ab0tj/RubeCron/README.md

This is just a goofy SBC I created for myself that is also a binary clock.
I have made it public in case it is helpful to anyone else, but it isn't intended to be finished product by any means.

That said, it works for me but YMMV.
