ab0tj/RubeCron/KiCad/v1-v2/RubeCron-r2.pdf

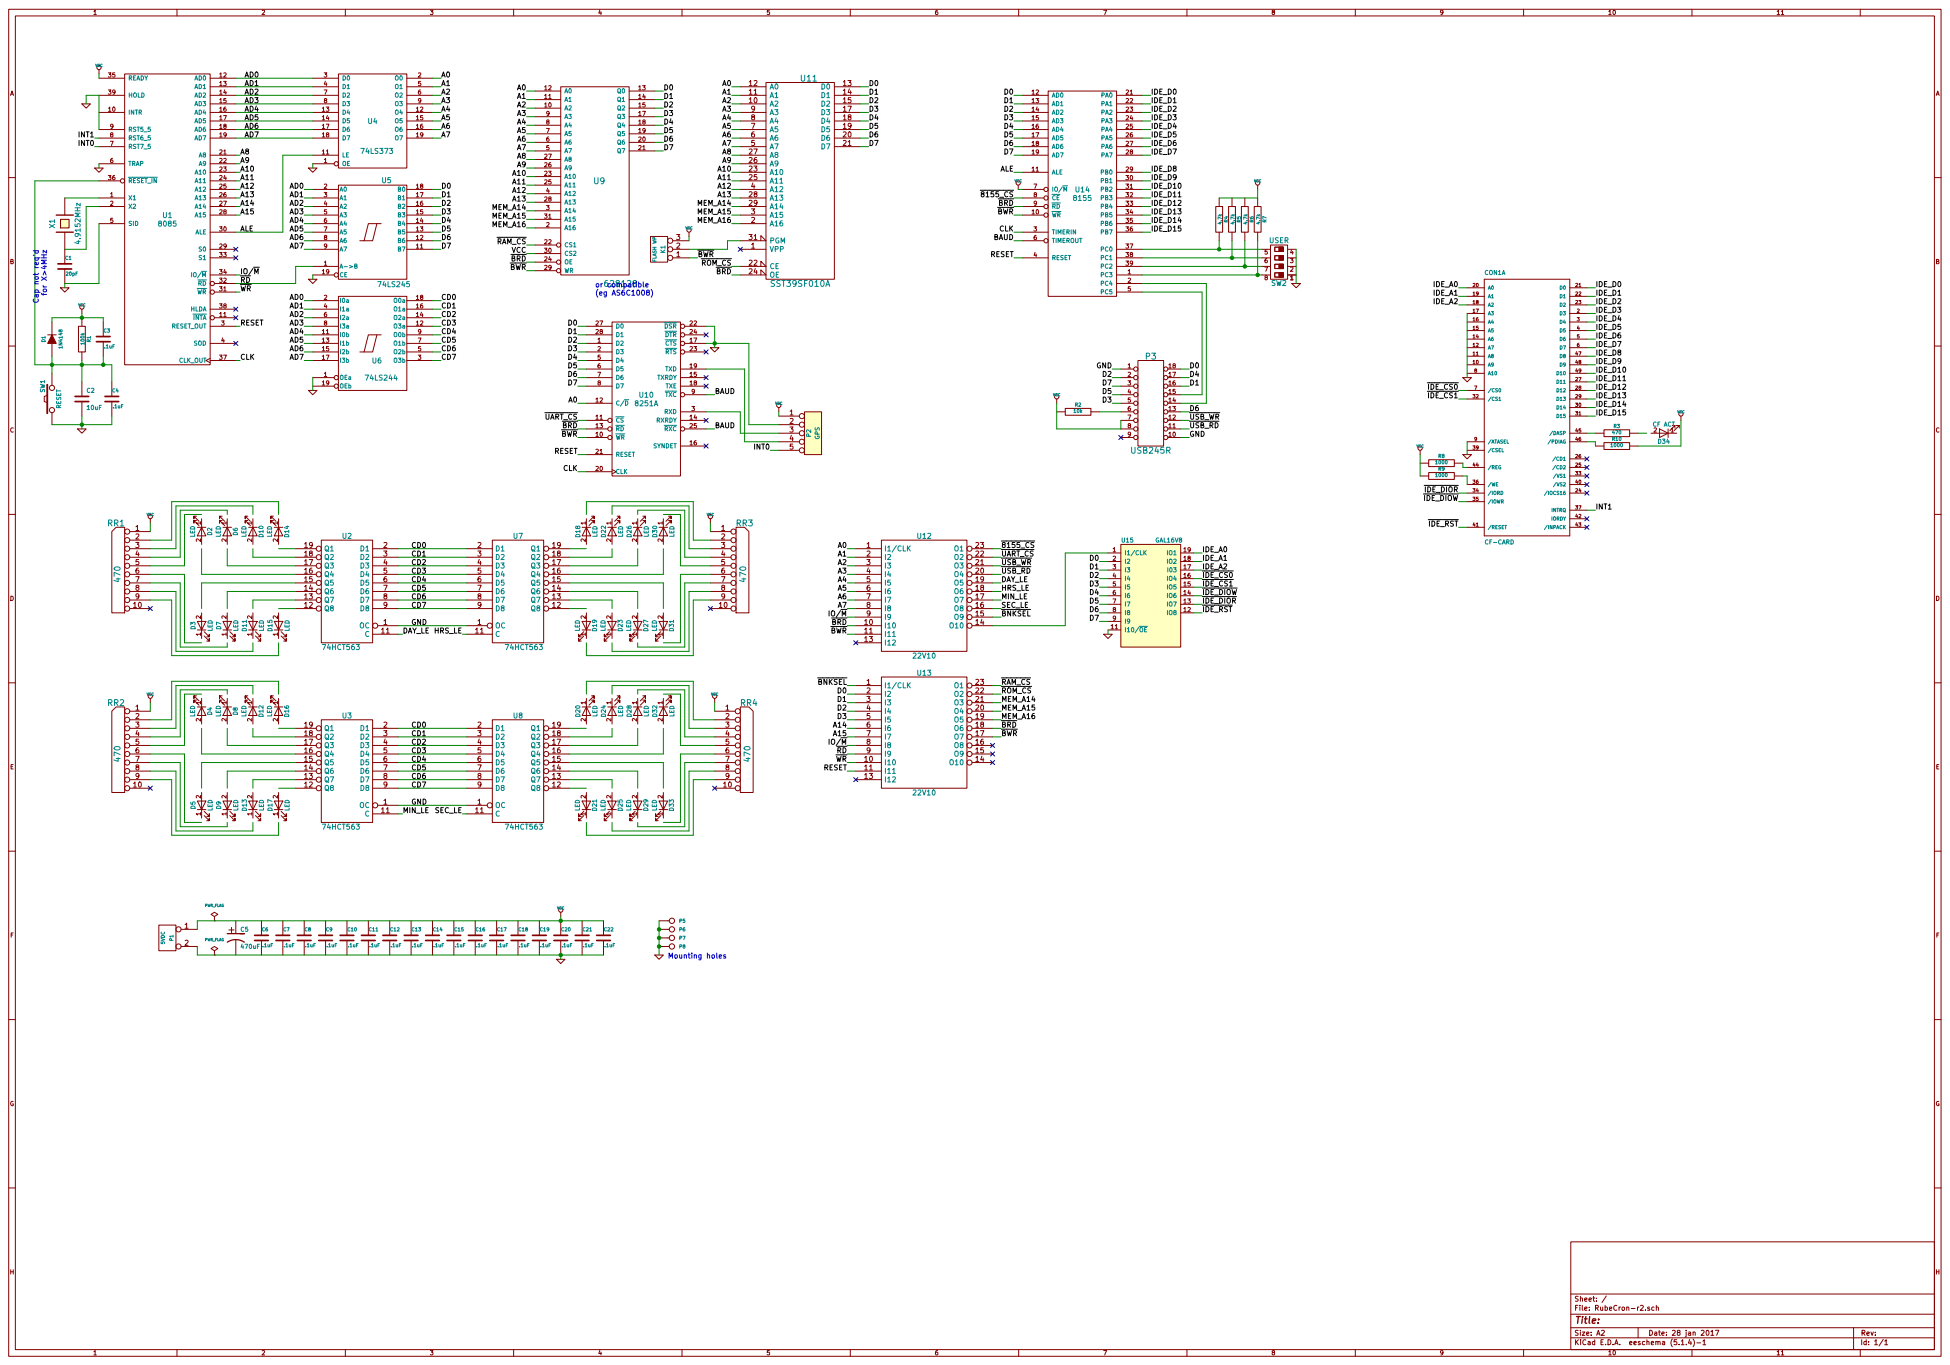
[picture p1: page 1]

Id: 1/1 Title: File: RubeCron-r2.sch Sheet: /
