ab0tj/RubeCron/KiCad/v3-v4/RubeCron-r3.pdf

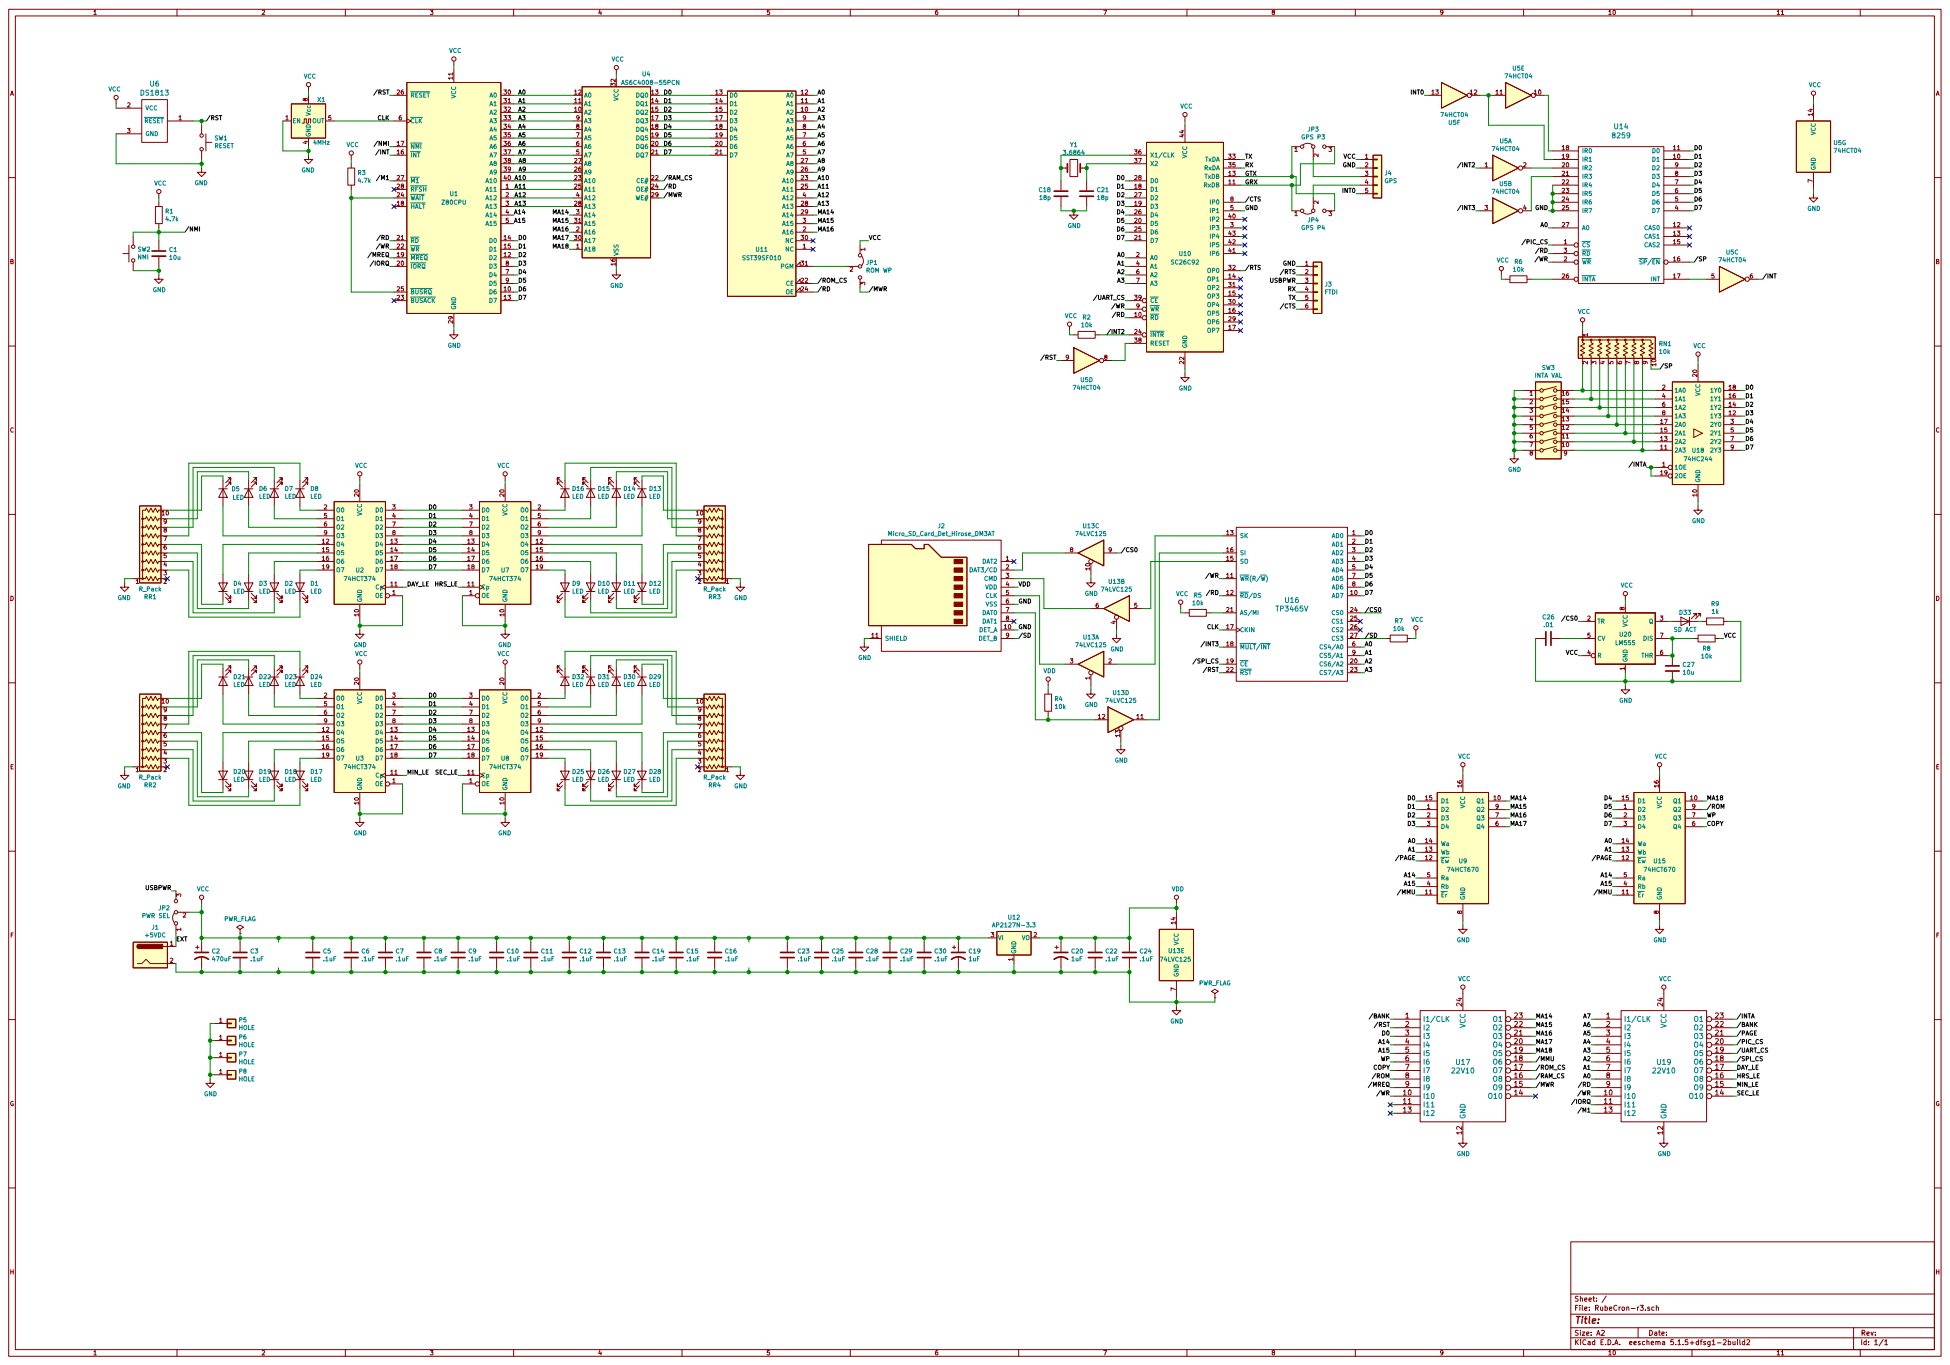
[picture p2: page 1]

Id: 1/1 Title: File: RubeCron-r3.sch Sheet: /
