ab0tj/RubeCron/KiCad/v1-v2/RubeCron.pdf

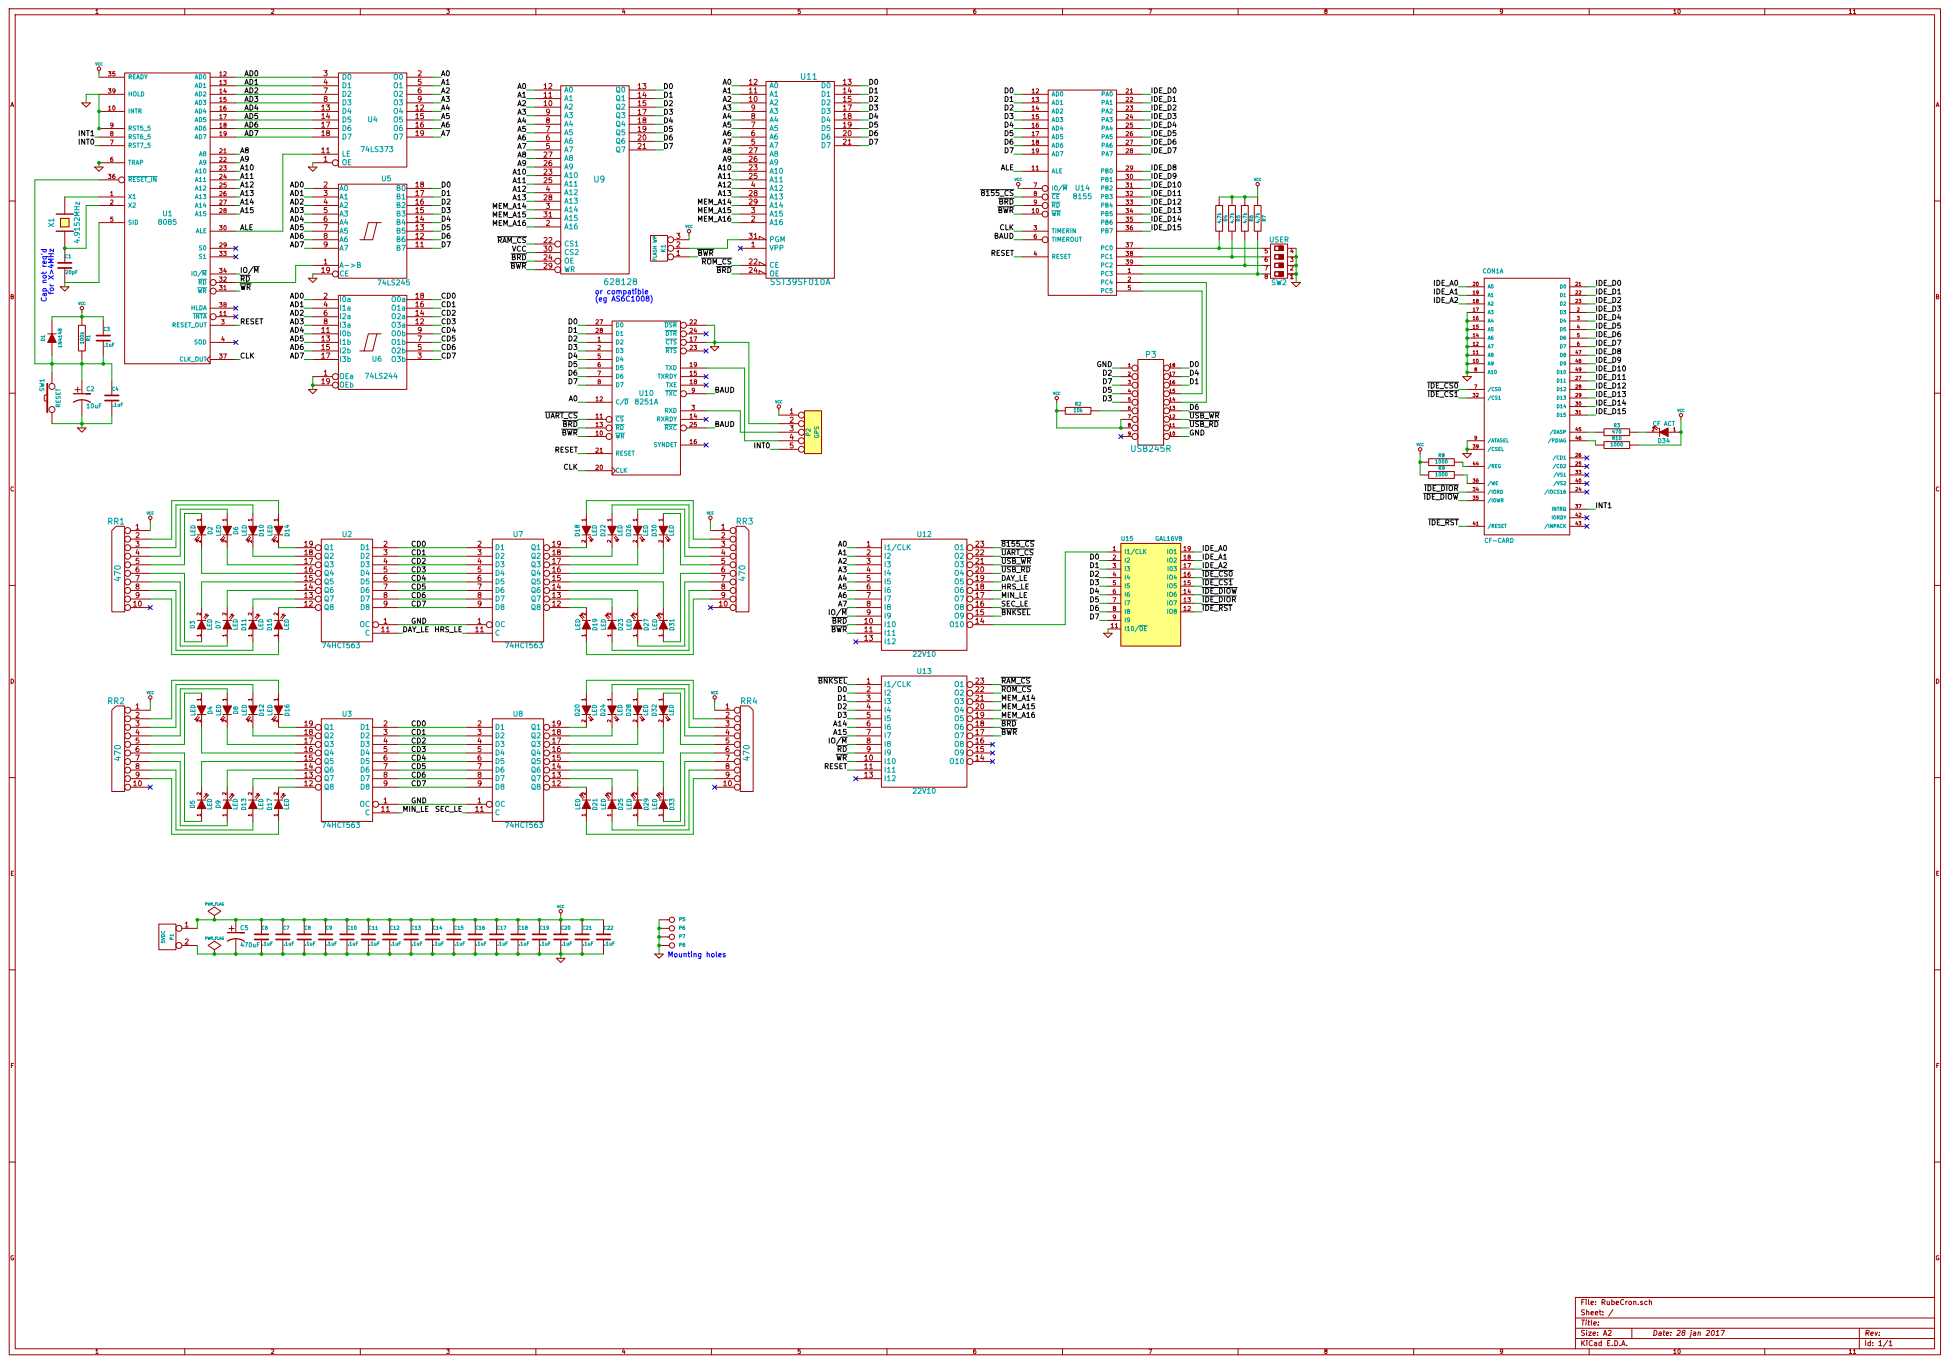
[picture p3: page 1]

Id: 1/1 Title: File: RubeCron.sch
Sheet: /
