ab0tj/RubeCron/KiCad/v3-v4/RubeCron-r3.kicad_pcb

## KiCad design KiCad/v3-v4/RubeCron-r3.kicad_pcb (2021-09-27)

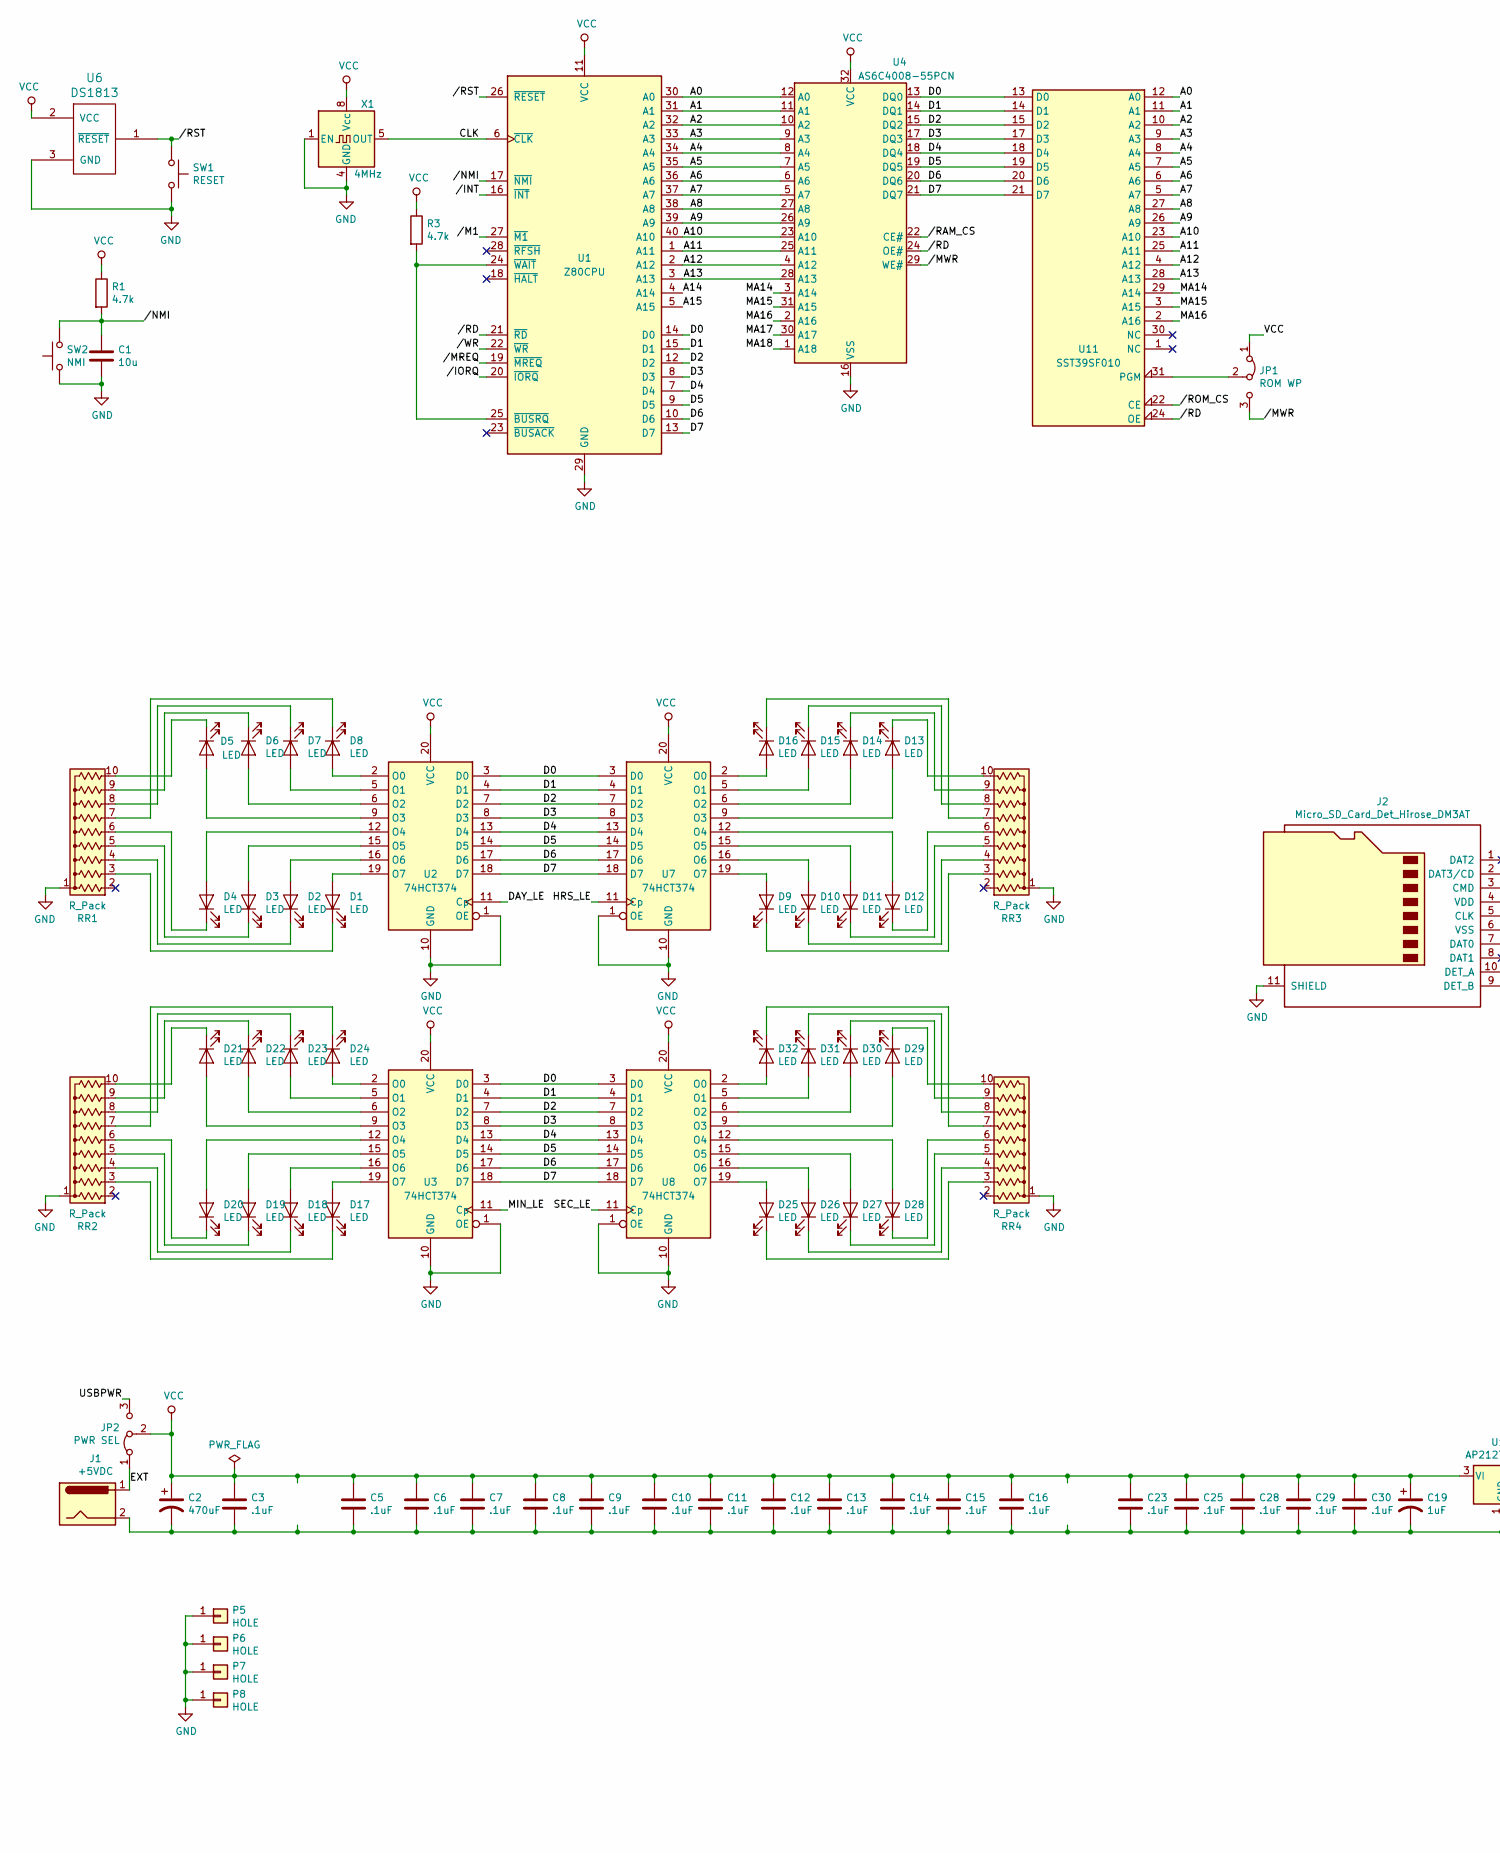
[picture p4: schematic RubeCron-r3.sch, part in row 1, column 1]

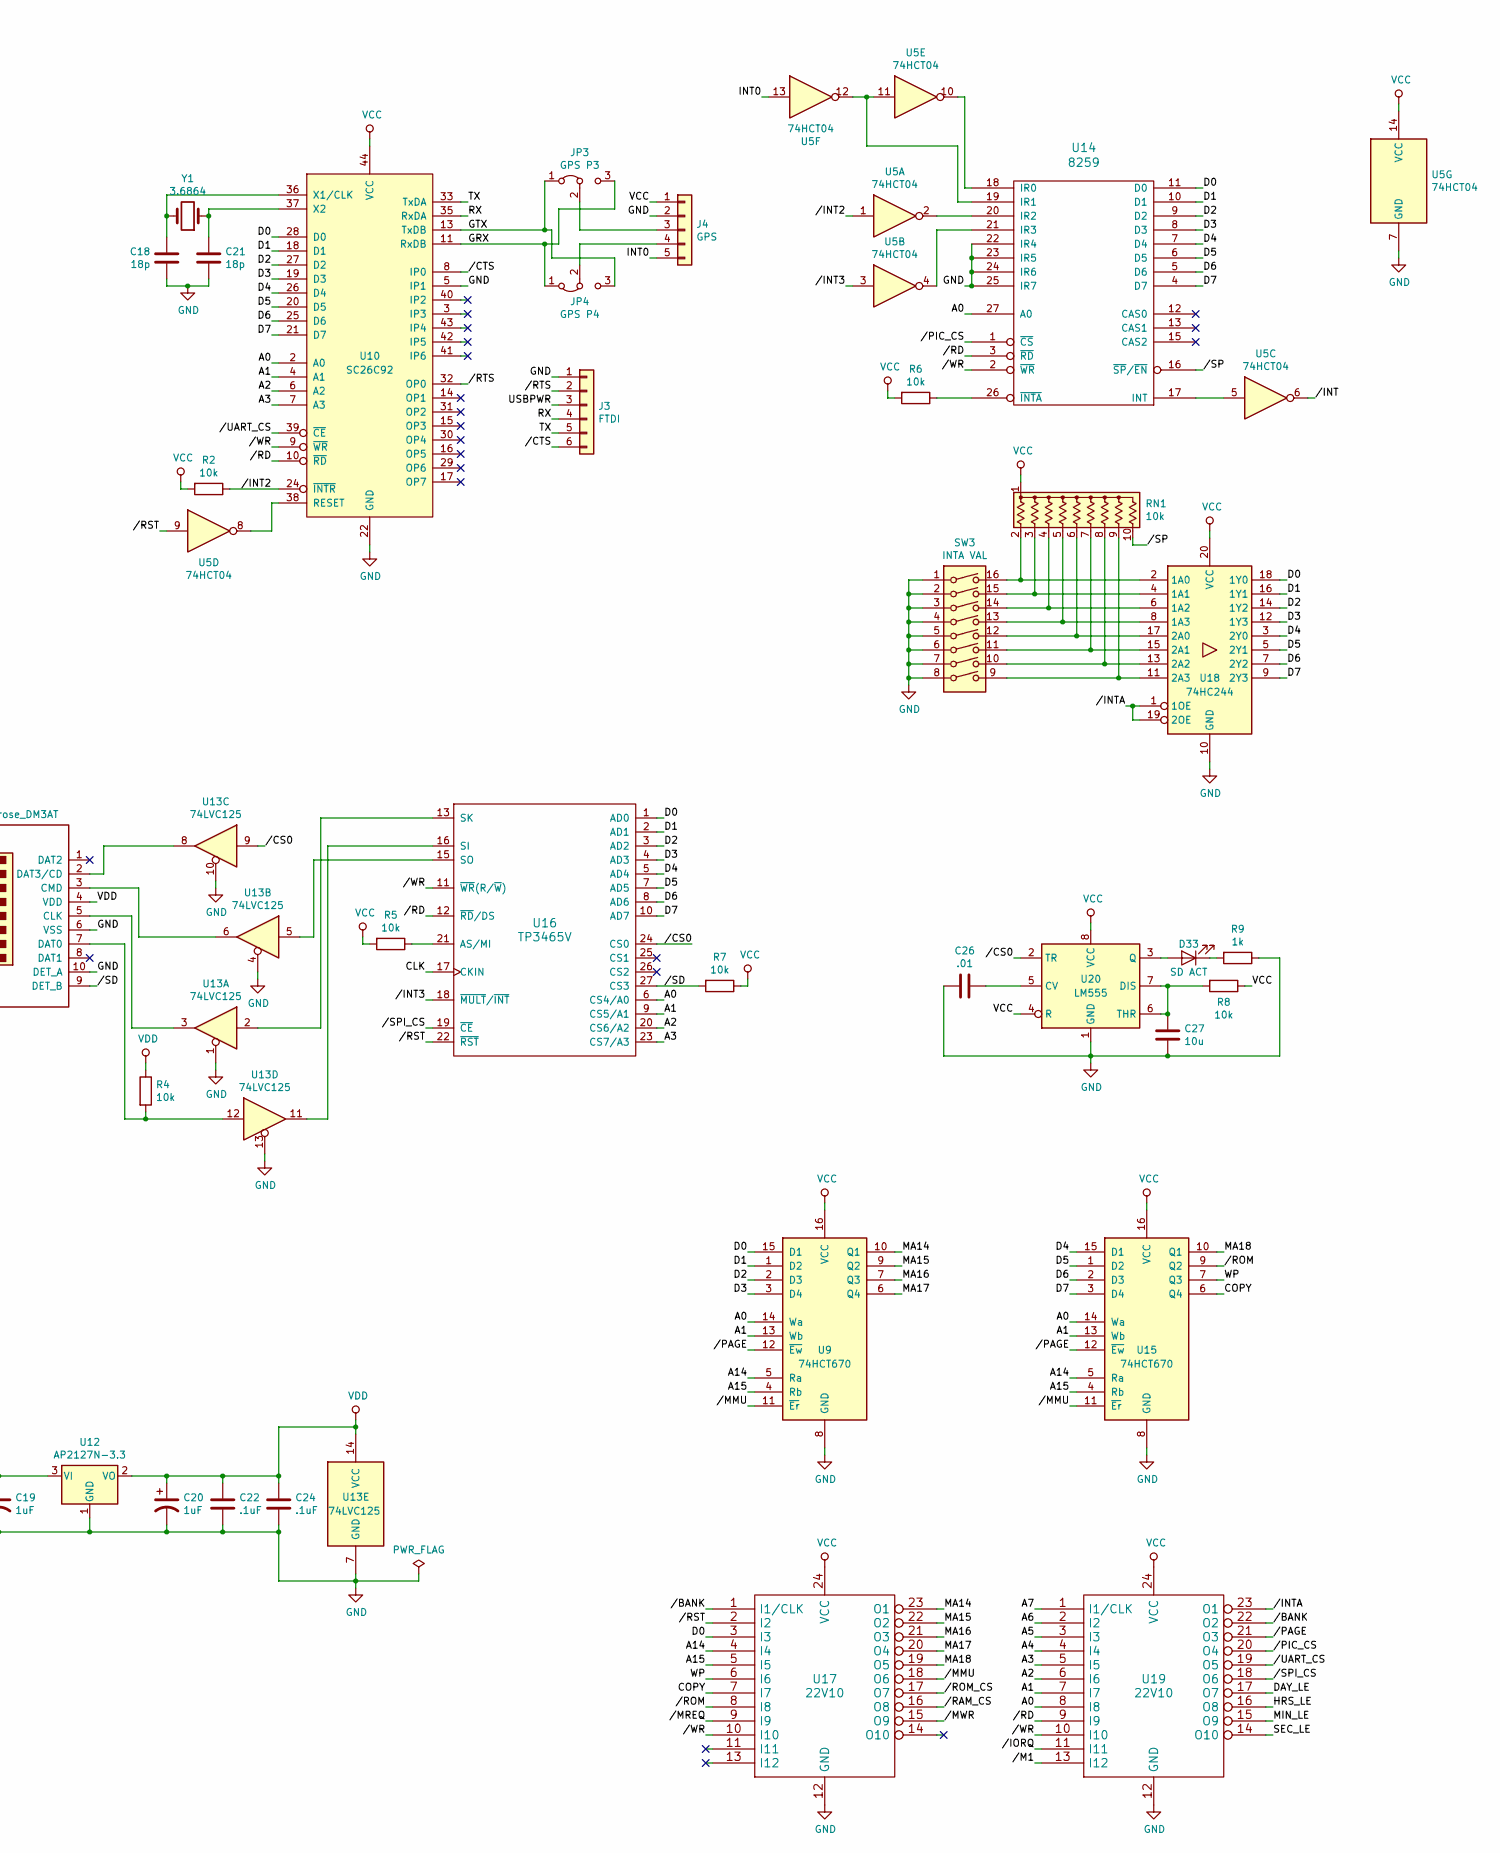
[picture p5: schematic RubeCron-r3.sch, part in row 1, column 2]

Parts:
C1, C27: 10u; C_Disc_D5.0mm_W2.5mm_P5.00mm
C2: 470uF; CP_Radial_D8.0mm_P3.50mm
C3, C5, C6, C7, C8, C9, C10, C11, C12, C13, C14, C15, C16, C23, C25, C28, C29, C30: .1uF; C_Disc_D5.0mm_W2.5mm_P5.00mm
C18, C21: 18p; C_Disc_D5.0mm_W2.5mm_P5.00mm
C19, C20: 1uF; C_0805_2012Metric_Pad1.15x1.40mm_HandSolder
C22, C24: .1uF; C_0805_2012Metric_Pad1.15x1.40mm_HandSolder
C26: .01; C_Disc_D5.0mm_W2.5mm_P5.00mm
D1, D2, D3, D4, D5, D6, D7, D8, D9, D10, D11, D12, D13, D14, D15, D16, D17, D18, D19, D20, D21, D22, D23, D24, D25, D26, D27, D28, D29, D30, D31, D32: LED; LED_D5.0mm
D33: SD ACT; LED_D3.0mm
J1: +5VDC; BarrelJack_CUI_PJ-102AH_Horizontal
J2: Micro_SD_Card_Det_Hirose_DM3AT; microSD_HC_Hirose_DM3AT-SF-PEJM5
J3: FTDI; PinHeader_1x06_P2.54mm_Horizontal
J4: GPS; PinSocket_1x05_P2.54mm_Vertical
JP1: ROM WP; PinHeader_1x03_P2.54mm_Vertical
JP2: PWR SEL; PinHeader_1x03_P2.54mm_Vertical
JP3: GPS P3; SolderJumper-3_P1.3mm_Open_Pad1.0x1.5mm
JP4: GPS P4; SolderJumper-3_P1.3mm_Open_Pad1.0x1.5mm
P5, P6, P7, P8: HOLE; MountingHole_3mm_Pad
R1, R3: 4.7k; R_Axial_DIN0207_L6.3mm_D2.5mm_P7.62mm_Horizontal
R2, R5, R6, R7, R8: 10k; R_Axial_DIN0207_L6.3mm_D2.5mm_P7.62mm_Horizontal
R4: 10k; R_0805_2012Metric_Pad1.15x1.40mm_HandSolder
R9: 1k; R_Axial_DIN0207_L6.3mm_D2.5mm_P7.62mm_Horizontal
RN1: 10k; R_Array_SIP10
RR1, RR2, RR3, RR4: R_Pack; R_Array_SIP10
SW1: RESET; SW_PUSH_6mm
SW2: NMI; SW_PUSH_6mm
SW3: INTA VAL; SW_DIP_SPSTx08_Slide_9.78x22.5mm_W7.62mm_P2.54mm
U1: Z80CPU; DIP-40_W15.24mm_Socket
U2, U3, U7, U8: 74HCT374; DIP-20_W7.62mm_Socket
U4: AS6C4008-55PCN; DIP-32_W15.24mm_Socket
U5: 74HCT04; DIP-14_W7.62mm_Socket
U6: DS1813; TO-92L_Inline
U9, U15: 74HCT670; DIP-16_W7.62mm_Socket
U10: SC26C92; PLCC-44_THT-Socket
U11: SST39SF010; DIP-32_W15.24mm_Socket
U12: AP2127N-3.3; SOT-23
U13: 74LVC125; SOIC-14_3.9x8.7mm_P1.27mm
U14: 8259; PLCC-28_THT-Socket
U16: TP3465V; PLCC-28_THT-Socket
U17, U19: 22V10; DIP-24_W7.62mm_Socket
U18: 74HC244; DIP-20_W7.62mm_Socket
U20: LM555; DIP-8_W7.62mm_Socket
X1: 4MHz; Oscillator_DIP-8
Y1: 3.6864; Crystal_HC49-U_Vertical

Connections:
//BANK: U17.1 (I1/CLK), U19.22 (O2)
//CS0: U13.9, U16.24 (CS0), U20.2 (TR)
//CTS: J3.6, U10.8 (IP0)
//INT: U1.16 (~INT~), U5.6
//INT2: R2.1, U5.1, U10.24 (~INTR)
//INT3: U5.3, U16.18 (~MULT~/~INT)
//INTA: U18.1 (1OE), U18.19 (2OE), U19.23 (O1)
//IORQ: U1.20 (~IORQ~), U19.11 (I11)
//M1: U1.27 (~M1~), U19.13 (I12)
//MMU: U9.11 (~Er), U15.11 (~Er), U17.18 (O6)
//MREQ: U1.19 (~MREQ~), U17.9 (I9)
//MWR: JP1.3 (B), U4.29 (WE#), U17.15 (O9)
//NMI: C1.1, R1.2, SW2.2, U1.17 (~NMI~)
//PAGE: U9.12 (~Ew), U15.12 (~Ew), U19.21 (O3)
//PIC_CS: U14.1 (~CS), U19.20 (O4)
//RAM_CS: U4.22 (CE#), U17.16 (O8)
//RD: U1.21 (~RD~), U4.24 (OE#), U10.10 (~RD), U11.24 (OE), U14.3 (~RD), U16.12 (~RD~/DS), U19.9 (I9)
//ROM: U15.9 (Q2), U17.8 (I8)
//ROM_CS: U11.22 (CE), U17.17 (O7)
//RST: SW1.2, U1.26 (~RESET~), U5.9, U6.1 (~RESET), U16.22 (~RST), U17.2 (I2)
//RTS: J3.2, U10.32 (OP0)
//SD: J2.9 (DET_B), R7.2, U16.27 (CS3)
//SP: RN1.10 (R9), U14.16 (~SP~/~EN~)
//SPI_CS: U16.19 (~CE), U19.18 (O6)
//UART_CS: U10.39 (~CE), U19.19 (O5)
//WR: U1.22 (~WR~), U10.9 (~WR), U14.2 (~WR), U16.11 (~WR~(R/~W~)), U17.10 (I10), U19.10 (I10)
/A0: U1.30 (A0), U4.12 (A0), U9.14 (Wa), U10.2 (A0), U11.12 (A0), U14.27 (A0), U15.14 (Wa), U16.6 (CS4/A0), U19.8 (I8)
/A1: U1.31 (A1), U4.11 (A1), U9.13 (Wb), U10.4 (A1), U11.11 (A1), U15.13 (Wb), U16.9 (CS5/A1), U19.7 (I7)
/A2: U1.32 (A2), U4.10 (A2), U10.6 (A2), U11.10 (A2), U16.20 (CS6/A2), U19.6 (I6)
/A3: U1.33 (A3), U4.9 (A3), U10.7 (A3), U11.9 (A3), U16.23 (CS7/A3), U19.5 (I5)
/A4: U1.34 (A4), U4.8 (A4), U11.8 (A4), U19.4 (I4)
/A5: U1.35 (A5), U4.7 (A5), U11.7 (A5), U19.3 (I3)
/A6: U1.36 (A6), U4.6 (A6), U11.6 (A6), U19.2 (I2)
/A7: U1.37 (A7), U4.5 (A7), U11.5 (A7), U19.1 (I1/CLK)
/A8: U1.38 (A8), U4.27 (A8), U11.27 (A8)
/A9: U1.39 (A9), U4.26 (A9), U11.26 (A9)
/A10: U1.40 (A10), U4.23 (A10), U11.23 (A10)
/A11: U1.1 (A11), U4.25 (A11), U11.25 (A11)
/A12: U1.2 (A12), U4.4 (A12), U11.4 (A12)
/A13: U1.3 (A13), U4.28 (A13), U11.28 (A13)
/A14: U1.4 (A14), U9.5 (Ra), U15.5 (Ra), U17.4 (I4)
/A15: U1.5 (A15), U9.4 (Rb), U15.4 (Rb), U17.5 (I5)
/CLK: U1.6 (~CLK~), U16.17 (CKIN), X1.5 (OUT)
/COPY: U15.6 (Q4), U17.7 (I7)
/D0: U1.14 (D0), U2.3 (D0), U3.3 (D0), U4.13 (DQ0), U7.3 (D0), U8.3 (D0), U9.15 (D1), U10.28 (D0), U11.13 (D0), U14.11 (D0), U16.1 (AD0), U17.3 (I3), U18.18 (1Y0)
/D1: U1.15 (D1), U2.4 (D1), U3.4 (D1), U4.14 (DQ1), U7.4 (D1), U8.4 (D1), U9.1 (D2), U10.18 (D1), U11.14 (D1), U14.10 (D1), U16.2 (AD1), U18.16 (1Y1)
/D2: U1.12 (D2), U2.7 (D2), U3.7 (D2), U4.15 (DQ2), U7.7 (D2), U8.7 (D2), U9.2 (D3), U10.27 (D2), U11.15 (D2), U14.9 (D2), U16.3 (AD2), U18.14 (1Y2)
/D3: U1.8 (D3), U2.8 (D3), U3.8 (D3), U4.17 (DQ3), U7.8 (D3), U8.8 (D3), U9.3 (D4), U10.19 (D3), U11.17 (D3), U14.8 (D3), U16.4 (AD3), U18.12 (1Y3)
/D4: U1.7 (D4), U2.13 (D4), U3.13 (D4), U4.18 (DQ4), U7.13 (D4), U8.13 (D4), U10.26 (D4), U11.18 (D4), U14.7 (D4), U15.15 (D1), U16.5 (AD4), U18.3 (2Y0)
/D5: U1.9 (D5), U2.14 (D5), U3.14 (D5), U4.19 (DQ5), U7.14 (D5), U8.14 (D5), U10.20 (D5), U11.19 (D5), U14.6 (D5), U15.1 (D2), U16.7 (AD5), U18.5 (2Y1)
/D6: U1.10 (D6), U2.17 (D6), U3.17 (D6), U4.20 (DQ6), U7.17 (D6), U8.17 (D6), U10.25 (D6), U11.20 (D6), U14.5 (D6), U15.2 (D3), U16.8 (AD6), U18.7 (2Y2)
/D7: U1.13 (D7), U2.18 (D7), U3.18 (D7), U4.21 (DQ7), U7.18 (D7), U8.18 (D7), U10.21 (D7), U11.21 (D7), U14.4 (D7), U15.3 (D4), U16.10 (AD7), U18.9 (2Y3)
/DAY_LE: U2.11 (Cp), U19.17 (O7)
/EXT: J1.1, JP2.1 (A)
/GRX: JP3.3 (B), JP4.1 (A), U10.11 (RxDB)
/GTX: JP3.1 (A), JP4.3 (B), U10.13 (TxDB)
/HRS_LE: U7.11 (Cp), U19.16 (O8)
/INT0: J4.5, U5.13
/MA14: U4.3 (A14), U9.10 (Q1), U11.29 (A14), U17.23 (O1)
/MA15: U4.31 (A15), U9.9 (Q2), U11.3 (A15), U17.22 (O2)
/MA16: U4.2 (A16), U9.7 (Q3), U11.2 (A16), U17.21 (O3)
/MA17: U4.30 (A17), U9.6 (Q4), U17.20 (O4)
/MA18: U4.1 (A18), U15.10 (Q1), U17.19 (O5)
/MIN_LE: U3.11 (Cp), U19.15 (O9)
/RX: J3.4, U10.35 (RxDA)
/SEC_LE: U8.11 (Cp), U19.14 (O10)
/TX: J3.5, U10.33 (TxDA)
/USBPWR: J3.3, JP2.3 (B)
/WP: U15.7 (Q3), U17.6 (I6)
GND: C1.2, C2.2, C3.2, C5.2, C6.2, C7.2, C8.2, C9.2, C10.2, C11.2, C12.2, C13.2, C14.2, C15.2, C16.2, C18.2, C19.2, C20.2, C21.2, C22.2, C23.2, C24.2, C25.2, C26.2, C27.2, C28.2, C29.2, C30.2, J1.2, J2.6 (VSS), J2.10 (DET_A), J2.11 (SHIELD), J3.1, J4.2, P5.1, P6.1, P7.1, P8.1, R9.1, RR1.1 (common), RR2.1 (common), RR3.1 (common), RR4.1 (common), SW1.1, SW2.1, SW3.1, SW3.2, SW3.3, SW3.4, SW3.5, SW3.6, SW3.7, SW3.8, U1.29 (GND), U2.1 (OE), U2.10 (GND), U3.1 (OE), U3.10 (GND), U4.16 (VSS), U5.7 (GND), U6.3 (GND), U7.1 (OE), U7.10 (GND), U8.1 (OE), U8.10 (GND), U9.8 (GND), U10.5 (IP1), U10.22 (GND), U11.16 (GND), U12.1 (GND), U13.1, U13.4, U13.7 (GND), U13.10, U13.13, U14.14 (GND), U14.22 (IR4), U14.23 (IR5), U14.24 (IR6), U14.25 (IR7), U15.8 (GND), U16.14 (GND), U17.12 (GND), U18.10 (GND), U19.12 (GND), U20.1 (GND), X1.1 (EN), X1.4 (GND)
unnamed: C18.1, U10.36 (X1/CLK), Y1.2
unnamed: C21.1, U10.37 (X2), Y1.1
unnamed: C26.1, U20.5 (CV)
unnamed: C27.1, R8.2, U20.6 (THR), U20.7 (DIS)
unnamed: D1.1 (K), RR1.3 (R2)
unnamed: D1.2 (A), U2.19 (O7)
unnamed: D2.1 (K), RR1.4 (R3)
unnamed: D2.2 (A), U2.16 (O6)
unnamed: D3.1 (K), RR1.5 (R4)
unnamed: D3.2 (A), U2.15 (O5)
unnamed: D4.1 (K), RR1.6 (R5)
unnamed: D4.2 (A), U2.12 (O4)
unnamed: D5.1 (K), RR1.10 (R9)
unnamed: D5.2 (A), U2.9 (O3)
unnamed: D6.1 (K), RR1.9 (R8)
unnamed: D6.2 (A), U2.6 (O2)
unnamed: D7.1 (K), RR1.8 (R7)
unnamed: D7.2 (A), U2.5 (O1)
unnamed: D8.1 (K), RR1.7 (R6)
unnamed: D8.2 (A), U2.2 (O0)
unnamed: D9.1 (K), RR3.3 (R2)
unnamed: D9.2 (A), U7.19 (O7)
unnamed: D10.1 (K), RR3.4 (R3)
unnamed: D10.2 (A), U7.16 (O6)
unnamed: D11.1 (K), RR3.5 (R4)
unnamed: D11.2 (A), U7.15 (O5)
unnamed: D12.1 (K), RR3.6 (R5)
unnamed: D12.2 (A), U7.12 (O4)
unnamed: D13.1 (K), RR3.10 (R9)
unnamed: D13.2 (A), U7.9 (O3)
unnamed: D14.1 (K), RR3.9 (R8)
unnamed: D14.2 (A), U7.6 (O2)
unnamed: D15.1 (K), RR3.8 (R7)
unnamed: D15.2 (A), U7.5 (O1)
unnamed: D16.1 (K), RR3.7 (R6)
unnamed: D16.2 (A), U7.2 (O0)
unnamed: D17.1 (K), RR2.3 (R2)
unnamed: D17.2 (A), U3.19 (O7)
unnamed: D18.1 (K), RR2.4 (R3)
unnamed: D18.2 (A), U3.16 (O6)
unnamed: D19.1 (K), RR2.5 (R4)
unnamed: D19.2 (A), U3.15 (O5)
unnamed: D20.1 (K), RR2.6 (R5)
unnamed: D20.2 (A), U3.12 (O4)
unnamed: D21.1 (K), RR2.10 (R9)
unnamed: D21.2 (A), U3.9 (O3)
unnamed: D22.1 (K), RR2.9 (R8)
unnamed: D22.2 (A), U3.6 (O2)
unnamed: D23.1 (K), RR2.8 (R7)
unnamed: D23.2 (A), U3.5 (O1)
unnamed: D24.1 (K), RR2.7 (R6)
unnamed: D24.2 (A), U3.2 (O0)
unnamed: D25.1 (K), RR4.3 (R2)
unnamed: D25.2 (A), U8.19 (O7)
unnamed: D26.1 (K), RR4.4 (R3)
unnamed: D26.2 (A), U8.16 (O6)
unnamed: D27.1 (K), RR4.5 (R4)
unnamed: D27.2 (A), U8.15 (O5)
unnamed: D28.1 (K), RR4.6 (R5)
unnamed: D28.2 (A), U8.12 (O4)
unnamed: D29.1 (K), RR4.10 (R9)
unnamed: D29.2 (A), U8.9 (O3)
unnamed: D30.1 (K), RR4.9 (R8)
unnamed: D30.2 (A), U8.6 (O2)
unnamed: D31.1 (K), RR4.8 (R7)
unnamed: D31.2 (A), U8.5 (O1)
unnamed: D32.1 (K), RR4.7 (R6)
unnamed: D32.2 (A), U8.2 (O0)
unnamed: D33.1 (K), R9.2
unnamed: D33.2 (A), U20.3 (Q)
unnamed: J2.2 (DAT3/CD), U13.8
unnamed: J2.3 (CMD), U13.6
unnamed: J2.5 (CLK), U13.3
unnamed: J2.7 (DAT0), R4.2, U13.12
unnamed: J4.3, JP3.2 (C)
unnamed: J4.4, JP4.2 (C)
unnamed: JP1.2 (C), U11.31 (PGM)
unnamed: R3.2, U1.24 (~WAIT~), U1.25 (~BUSRQ~)
unnamed: R5.1, U16.21 (AS/MI)
unnamed: R6.1, U14.26 (~INTA)
unnamed: RN1.2 (R1), SW3.16, U18.2 (1A0)
unnamed: RN1.3 (R2), SW3.15, U18.4 (1A1)
unnamed: RN1.4 (R3), SW3.14, U18.6 (1A2)
unnamed: RN1.5 (R4), SW3.13, U18.8 (1A3)
unnamed: RN1.6 (R5), SW3.12, U18.17 (2A0)
unnamed: RN1.7 (R6), SW3.11, U18.15 (2A1)
unnamed: RN1.8 (R7), SW3.10, U18.13 (2A2)
unnamed: RN1.9 (R8), SW3.9, U18.11 (2A3)
unnamed: U5.8, U10.38 (RESET)
unnamed: U13.2, U16.13 (SK)
unnamed: U13.5, U16.15 (SO)
unnamed: U13.11, U16.16 (SI)
unnamed: U5.5, U14.17 (INT)
unnamed: U5.10, U14.18 (IR0)
unnamed: U5.11, U5.12, U14.19 (IR1)
unnamed: U5.2, U14.20 (IR2)
unnamed: U5.4, U14.21 (IR3)
VCC: C2.1, C3.1, C5.1, C6.1, C7.1, C8.1, C9.1, C10.1, C11.1, C12.1, C13.1, C14.1, C15.1, C16.1, C19.1, C23.1, C25.1, C28.1, C29.1, C30.1, J4.1, JP1.1 (A), JP2.2 (C), R1.1, R2.2, R3.1, R5.2, R6.2, R7.1, R8.1, RN1.1 (common), U1.11 (VCC), U2.20 (VCC), U3.20 (VCC), U4.32 (VCC), U5.14 (VCC), U6.2 (VCC), U7.20 (VCC), U8.20 (VCC), U9.16 (VCC), U10.44 (VCC), U11.32 (VCC), U12.3 (VI), U14.28 (VCC), U15.16 (VCC), U16.28 (VCC), U17.24 (VCC), U18.20 (VCC), U19.24 (VCC), U20.4 (R), U20.8 (VCC), X1.8 (Vcc)
VDD: C20.1, C22.1, C24.1, J2.4 (VDD), R4.1, U12.2 (VO), U13.14 (VCC)

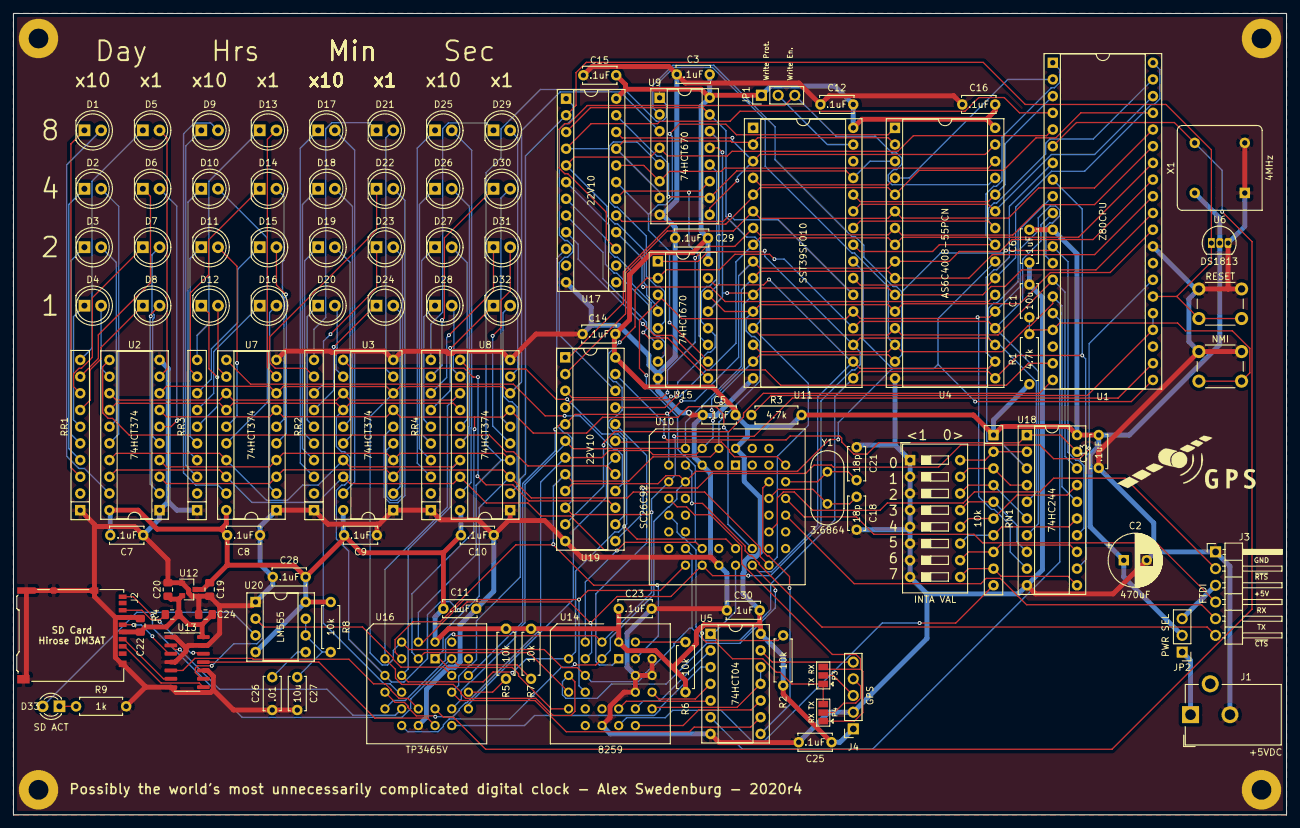
[picture p6: board RubeCron-r3.kicad_pcb from above]

Board: 2 copper layers, 193.7 x 121.9 mm, 114 parts (1 on the bottom side), 169 nets.

Other parts of the board:
G2: LOGO; GPSLOGO
G3: LOGO; MRSPARLKE2
