ab0tj/RubeCron/KiCad/v1-v2/RubeCron.kicad_pcb

## KiCad design KiCad/v1-v2/RubeCron.kicad_pcb (2018-04-02)

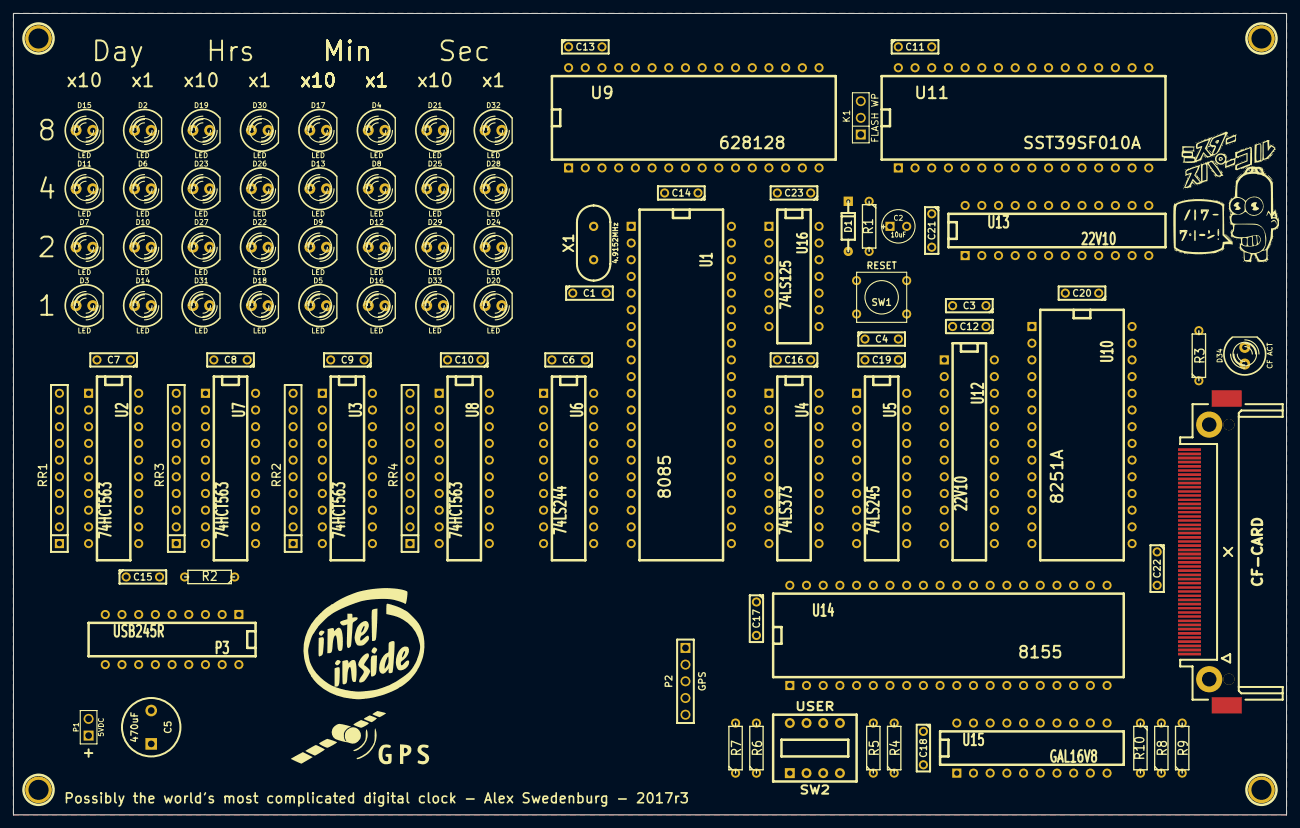
[picture p7: board RubeCron.kicad_pcb from above]

Board: 2 copper layers, 193.7 x 121.9 mm, 102 parts (0 on the bottom side), 177 nets, no tracks yet.

Parts:
C1: 20pF; C2
C2: 10uF; C1V5
C3, C4, C6, C7, C8, C9, C10, C11, C12, C13, C14, C15, C16, C17, C18, C19, C20, C21, C22, C23: .1uF; C2
C5: 470uF; C2V8
CON1: CF-CARD; 3M-N7E50-Short-NonInv
D1: 1N4148; DO-35
D2, D3, D4, D5, D6, D7, D8, D9, D10, D11, D12, D13, D14, D15, D16, D17, D18, D19, D20, D21, D22, D23, D24, D25, D26, D27, D28, D29, D30, D31, D32, D33: LED; LED-5MM
D34: CF ACT; LED-5MM
G1: LOGO; INTEL
G2: LOGO; GPSLOGO
G3: LOGO; MRSPARLKE2
K1: FLASH WP; PIN_ARRAY_3X1
P1: 5VDC; PIN_ARRAY_2X1
P2: GPS; PIN_ARRAY_5x1
P3: USB245R; DIP-18__300
P5, P6, P7, P8: CONN_1; 1pin
R1: 100k; R3
R2: 10k; R3
R3: 470; R3
R4, R5, R6, R7: 4.7k; R3
R8, R9, R10: 1000; R3
RR1, RR2, RR3, RR4: 470; r_pack9
SW1: RESET; SW_PUSH_SMALL
SW2: USER; SWDIP4
U1: 8085; DIP-40__600
U2, U3, U7, U8: 74HCT563; DIP-20__300
U4: 74LS373; DIP-20__300
U5: 74LS245; DIP-20__300
U6: 74LS244; DIP-20__300
U9: 628128; DIP-32__600
U10: 8251A; DIP-28__600
U11: SST39SF010A; DIP-32__600
U12, U13: 22V10; DIP-24__300
U14: 8155; DIP-40__600
U15: GAL16V8; DIP-20__300
U16: 74LS125; DIP-14__300
X1: 4.9152MHz; HC-49V

Connections:
/A0: U4.2, U9.12, U10.12, U11.12, U12.1
/A1: U4.5, U9.11, U11.11, U12.2
/A2: U4.6, U9.10, U11.10, U12.3
/A3: U4.9, U9.9, U11.9, U12.4
/A4: U4.12, U9.8, U11.8, U12.5
/A5: U4.15, U9.7, U11.7, U12.6
/A6: U4.16, U9.6, U11.6, U12.7
/A7: U4.19, U9.5, U11.5, U12.8
/A8: U1.21, U9.27, U11.27
/A9: U1.22, U9.26, U11.26
/A10: U1.23, U9.23, U11.23
/A11: U1.24, U9.25, U11.25
/A12: U1.25, U9.4, U11.4
/A13: U1.26, U9.28, U11.28
/A14: U1.27, U13.6
/A15: U1.28, U13.7
/AD0: U1.12, U4.3, U5.2, U6.2
/AD1: U1.13, U4.4, U5.3, U6.4
/AD2: U1.14, U4.7, U5.4, U6.6
/AD3: U1.15, U4.8, U5.5, U6.8
/AD4: U1.16, U4.13, U5.6, U6.11
/AD5: U1.17, U4.14, U5.7, U6.13
/AD6: U1.18, U4.17, U5.8, U6.15
/AD7: U1.19, U4.18, U5.9, U6.17
/ALE: U1.30, U4.11, U14.11
/BAUD: U10.9, U10.25, U14.6
/BCLK: U10.20, U12.13, U13.13, U14.3, U16.11
/BRESET: U10.21, U13.11, U14.4, U16.6
/CD0: U2.2, U3.2, U6.18, U7.2, U8.2
/CD1: U2.3, U3.3, U6.16, U7.3, U8.3
/CD2: U2.4, U3.4, U6.14, U7.4, U8.4
/CD3: U2.5, U3.5, U6.12, U7.5, U8.5
/CD4: U2.6, U3.6, U6.9, U7.6, U8.6
/CD5: U2.7, U3.7, U6.7, U7.7, U8.7
/CD6: U2.8, U3.8, U6.5, U7.8, U8.8
/CD7: U2.9, U3.9, U6.3, U7.9, U8.9
/CLK: U1.37, U16.12
/D0: P3.18, U5.18, U9.13, U10.27, U11.13, U13.2, U14.12, U15.2
/D1: P3.16, U5.17, U9.14, U10.28, U11.14, U13.3, U14.13, U15.3
/D2: P3.2, U5.16, U9.15, U10.1, U11.15, U13.4, U14.14, U15.4
/D3: P3.5, U5.15, U9.17, U10.2, U11.17, U13.5, U14.15, U15.5
/D4: P3.17, U5.14, U9.18, U10.5, U11.18, U14.16, U15.6
/D5: P3.4, U5.13, U9.19, U10.6, U11.19, U14.17, U15.7
/D6: P3.13, U5.12, U9.20, U10.7, U11.20, U14.18, U15.8
/D7: P3.3, U5.11, U9.21, U10.8, U11.21, U14.19, U15.9
/DAY_LE: U2.11, U12.19
/HRS_LE: U7.11, U12.18
/IDE_A0: CON1.20, U15.19
/IDE_A1: CON1.19, U15.18
/IDE_A2: CON1.18, U15.17
/IDE_D0: CON1.21, U14.21
/IDE_D1: CON1.22, U14.22
/IDE_D2: CON1.23, U14.23
/IDE_D3: CON1.2, U14.24
/IDE_D4: CON1.3, U14.25
/IDE_D5: CON1.4, U14.26
/IDE_D6: CON1.5, U14.27
/IDE_D7: CON1.6, U14.28
/IDE_D8: CON1.47, U14.29
/IDE_D9: CON1.48, U14.30
/IDE_D10: CON1.49, U14.31
/IDE_D11: CON1.27, U14.32
/IDE_D12: CON1.28, U14.33
/IDE_D13: CON1.29, U14.34
/IDE_D14: CON1.30, U14.35
/IDE_D15: CON1.31, U14.36
/INT0: P2.5, U1.7
/INT1: U1.8, U10.14
/INT2: CON1.37, U1.9
/IO/~M: U1.34, U12.9, U13.8
/MEM_A14: U9.3, U11.29, U13.21
/MEM_A15: U9.31, U11.3, U13.20
/MEM_A16: U9.2, U11.2, U13.19
/MIN_LE: U3.11, U12.17
/RESET: U1.3, U16.5
/SEC_LE: U8.11, U12.16
/~8155_CS: U12.23, U14.8
/~BNKSEL: U12.15, U13.1
/~BRD: U9.24, U10.13, U11.24, U12.10, U13.9, U14.9, U16.3
/~BWR: K1.1, U9.29, U10.10, U12.11, U13.10, U14.10, U16.8
/~IDE_CS0: CON1.7, U15.16
/~IDE_CS1: CON1.32, U15.15
/~IDE_DIOR: CON1.34, U15.13
/~IDE_DIOW: CON1.35, U15.14
/~IDE_RST: CON1.41, U15.12
/~RAM_CS: U9.22, U13.23
/~RD: U1.32, U5.1, U16.2
/~ROM_CS: U11.22, U13.22
/~UART_CS: U10.11, U12.22
/~USB_RD: P3.11, U12.20
/~USB_WR: P3.12, U12.21
/~WR: U1.31, U16.9
GND: C1.2, C2.2, C4.2, C5.2, C6.2, C7.2, C8.2, C9.2, C10.2, C11.2, C12.2, C13.2, C14.2, C15.2, C16.2, C17.2, C18.2, C19.2, C20.2, C21.2, C22.2, C23.2, CON1.1, CON1.8, CON1.9, CON1.10, CON1.11, CON1.12, CON1.14, CON1.15, CON1.16, CON1.17, CON1.39, CON1.50, P1.2, P2.2, P3.1, P3.10, P5.1, P6.1, P7.1, P8.1, SW1.1, SW2.1, SW2.2, SW2.3, SW2.4, U1.5, U1.6, U1.10, U1.20, U1.39, U2.1, U2.10, U3.1, U3.10, U4.1, U4.10, U5.10, U5.19, U6.1, U6.10, U6.19, U7.1, U7.10, U8.1, U8.10, U9.16, U10.4, U10.17, U10.22, U11.16, U12.12, U13.12, U14.20, U15.10, U15.11, U16.1, U16.4, U16.7, U16.10, U16.13
unnamed: P2.3, U10.3
unnamed: P2.4, U10.19
unnamed: P3.6, R2.2
unnamed: D10.2, U2.18
unnamed: D6.2, U2.17
unnamed: D2.2, U2.16
unnamed: D15.2, U2.12
unnamed: D11.2, U2.13
unnamed: D7.2, U2.14
unnamed: D3.2, U2.15
unnamed: D14.2, U2.19
unnamed: D16.2, U3.19
unnamed: D12.2, U3.18
unnamed: D8.2, U3.17
unnamed: D4.2, U3.16
unnamed: D17.2, U3.12
unnamed: D13.2, U3.13
unnamed: D9.2, U3.14
unnamed: K1.2, U11.31
unnamed: D5.2, U3.15
unnamed: D24.1, RR4.3
unnamed: D20.1, RR4.2
unnamed: D33.1, RR4.6
unnamed: D29.1, RR4.7
unnamed: D25.1, RR4.8
unnamed: D21.1, RR4.9
unnamed: D18.1, RR3.2
unnamed: D31.1, RR3.6
unnamed: D27.1, RR3.7
unnamed: D23.1, RR3.8
unnamed: D19.1, RR3.9
unnamed: D32.1, RR4.5
unnamed: D28.1, RR4.4
unnamed: D34.2, R3.2
unnamed: D33.2, U8.15
unnamed: D3.1, RR1.6
unnamed: D7.1, RR1.7
unnamed: D29.2, U8.14
unnamed: D11.1, RR1.8
unnamed: D15.1, RR1.9
unnamed: D2.1, RR1.5
unnamed: D6.1, RR1.4
unnamed: D31.2, U7.15
unnamed: D18.2, U7.19
unnamed: D22.2, U7.18
unnamed: D26.2, U7.17
unnamed: D30.2, U7.16
unnamed: D19.2, U7.12
unnamed: D23.2, U7.13
unnamed: D27.2, U7.14
unnamed: D20.2, U8.19
unnamed: D24.2, U8.18
unnamed: D28.2, U8.17
unnamed: D32.2, U8.16
unnamed: D21.2, U8.12
unnamed: D25.2, U8.13
unnamed: D5.1, RR2.6
unnamed: D9.1, RR2.7
unnamed: D13.1, RR2.8
unnamed: D17.1, RR2.9
unnamed: D30.1, RR3.5
unnamed: D26.1, RR3.4
unnamed: D22.1, RR3.3
unnamed: D10.1, RR1.3
unnamed: D14.1, RR1.2
unnamed: D4.1, RR2.5
unnamed: D8.1, RR2.4
unnamed: D12.1, RR2.3
unnamed: D16.1, RR2.2
unnamed: CON1.36, R9.2
unnamed: CON1.45, R3.1
unnamed: CON1.44, R8.2
unnamed: CON1.46, R10.1
unnamed: C2.1, C3.2, C4.1, D1.1, R1.2, SW1.2, U1.36
unnamed: U1.1, X1.2
unnamed: C1.1, U1.2, X1.1
unnamed: U12.14, U15.1
unnamed: R7.2, SW2.8, U14.1
unnamed: P3.14, U14.2
unnamed: P3.15, U14.5
unnamed: R6.2, SW2.7, U14.39
unnamed: R5.2, SW2.6, U14.38
unnamed: R4.2, SW2.5, U14.37
VCC: C3.1, C5.1, C6.1, C7.1, C8.1, C9.1, C10.1, C11.1, C12.1, C13.1, C14.1, C15.1, C16.1, C17.1, C18.1, C19.1, C20.1, C21.1, C22.1, C23.1, CON1.13, CON1.38, D1.2, D34.1, K1.3, P1.1, P2.1, P3.7, P3.8, R1.1, R2.1, R4.1, R5.1, R6.1, R7.1, R8.1, R9.1, R10.2, RR1.1, RR2.1, RR3.1, RR4.1, U1.35, U1.40, U2.20, U3.20, U4.20, U5.20, U6.20, U7.20, U8.20, U9.30, U9.32, U10.26, U11.32, U12.24, U13.24, U14.7, U14.40, U15.20, U16.14
