ab0tj/RubeCron/(commit log)

2018-04-02 First push
    [RubeCron-Routed-B_Cu.gbl, RubeCron-Routed-B_Mask.gbs, RubeCron-Routed-B_SilkS.gbo, RubeCron-Routed-Edge_Cuts.gbr, RubeCron-Routed-F_Cu.gtl, RubeCron-Routed-F_Mask.gts, RubeCron-Routed-F_SilkS.gto, RubeCron-Routed.drl]
2021-09-27 Add v4 files
    [RubeCron-r2-Routed.kicad_pcb, RubeCron-r2.kicad_pcb, RubeCron-r2.sch, RubeCron-r3.kicad_pcb, RubeCron-r3.sch, RubeCron.kicad_pcb, RubeCron.sch]
2021-09-27 Removed deleted files from repo
    [RubeCron-Routed-B_Cu.gbl, RubeCron-Routed-B_Mask.gbs, RubeCron-Routed-B_SilkS.gbo, RubeCron-Routed-Edge_Cuts.gbr, RubeCron-Routed-F_Cu.gtl, RubeCron-Routed-F_Mask.gts, RubeCron-Routed-F_SilkS.gto, RubeCron-Routed.drl]
